AloeVeraZ/PushBot/(commit log)

2026-09-30 Revive PushBot with embedded Wi-Fi driver station and motor failsafes
    [config.h, control.h, control_test.cpp, embed_ui.py, main.cpp, protocol.h]
2026-09-30 Compile firmware and check driver controls on every push
2026-10-06 Add Arduino Pushbot firmware and testing copy
2026-10-07 Add home Wi-Fi joining, phone layouts and motor-pin diagnostics
    - Wi-Fi tab: scan, save one home network, join it at power-on and fall back
    to the Pushbot hotspot when it is out of range or rejected; retry while
    the hotspot is idle. Reachable at http://pushbot.local/ or its address.
    - Phone layouts: Stop above the sticks in portrait, sticks at the edges with
    controls between them in landscape.
    - Battery robustness: 8.5 dBm Wi-Fi power, 80 MHz CPU, brownout-aware
    startup with a magenta LED cue and reset reason reporting. Brownout
    protection unchanged.
    - Recreate the RMT channel if an async LED write fails.
    - Watchdog 350 -> 500 ms to tolerate home Wi-Fi latency.
    - USB "?" status wit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
    [Pushbot.ino]
2026-10-07 Rewrite README around the project and promote the final firmware
    - README: what PushBot is, the goal, features, driving, hardware and pin
    map, Arduino IDE flashing, known issues, and repo layout, with a photo.
    - firmware/Pushbot now matches the tested firmware in testing/.
    - CI also runs the final firmware's browser tests.
    [Pushbot.ino]
